mlarroque/TP-ELECTRO1/informe/imagenes/el_diego_foto_real.png

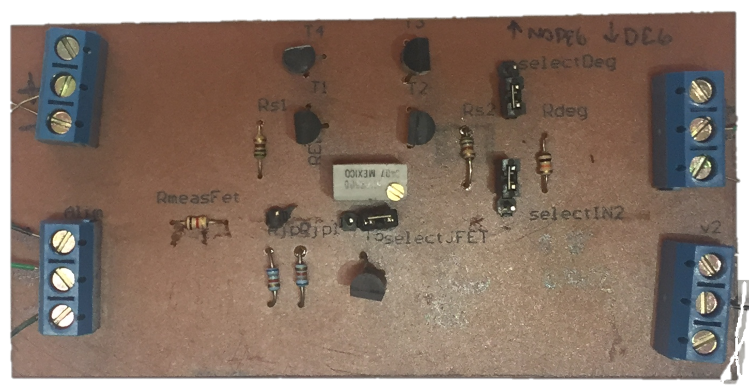
informe/imagenes/el_diego_foto_real.png
