mlarroque/TP-ELECTRO1/informe/imagenes/MonecarloDeCorrienteEnJFET.JPG

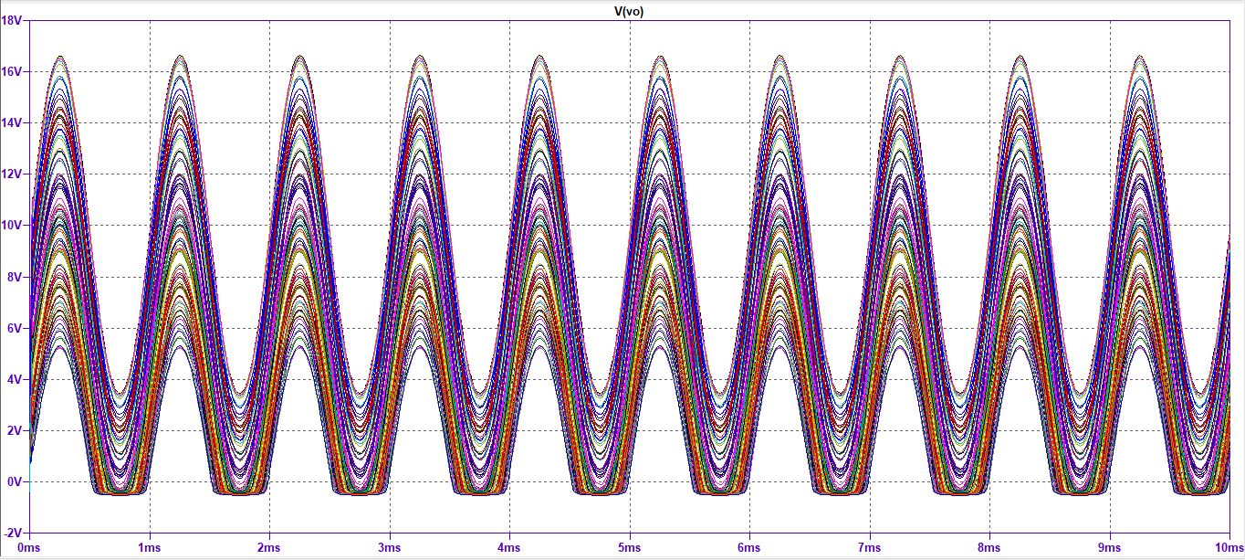
informe/imagenes/MonecarloDeCorrienteEnJFET.JPG
