mlarroque/TP-ELECTRO1/informe/informe_electro1.pdf

## Instituto Tecnológico de Buenos Aires

22.59 Electronica 1

Trabajo Práctico de Laboratorio No 2

# Amplicador Diferencial

Grupo 5:

Matías Larroque
Leg. 56597

Ariel Martorell
Leg. 56209

Manuel Mollón
Leg. 58023

Ezequiel Vijande
Leg. 58057

Profesor:

Fernando Alcocer
Pablo Gardella
Eduardo Oreglia

Entregado: 14 de Noviembre de 2018

## Índice

1. Amplicador Diferencial | 2

## 1. Amplicador Diferencial

1.1. Introducción

En este artículo se procederá a desarrollar el proceso de diseño e implementación de un amplicador con componentes (transistores y resistencias) discretos. El proceso de diseño se debe realizar a partir de los componentes que se adquieran dentro del marco de una simulación con recursos escasos, y en cuanto a al implementación, se realizará un prototipo que se pondrá a prueba mediante mediciones pertinentes para comprobar el funcionamiento del mismo.

1.2. Componentes Adquiridos

Los componentes adquiridos mediante la simulación de subasta son los siguientes: Par diferencial (con transistores NPN, BC547)
Transistor J-FET (de canal N, MPF102)
Transistor bipolar (NPN, BC557)
Fuente Espejo (con transistores PNP, BC547) Resistencia de 10KΩ
Resistencia de 6,8KΩ (dos unidades)
Placa de 5cm X 10 cm.
1.3. Elección del Circuito
1.3.1. Primera Aproximación - Circuito con Par Diferencial

Para la elección del circuito, se partirá de la siguiente conguración con un par diferencial:

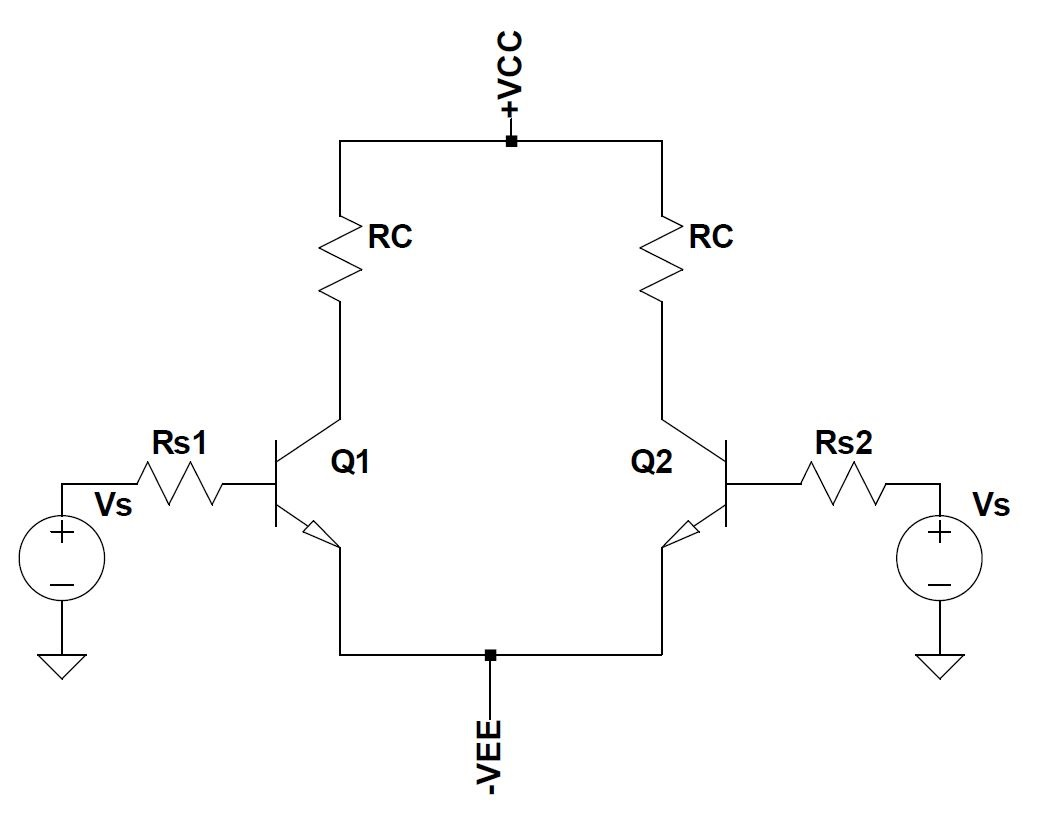
[picture p3: figure]

Figura 1: Circuito con Par Diferencial

Al resolver la polarización de este circuito, se podría plantear lo siguiente: IcQ1 ≈ IcQ2 ≈

VEE−VBEon
Rs1
HF E +2.REE

= IcQ
VCE = VCC + VEE − 2.IcQ.REE
Siendo HF E la ganancia de corriente (estática) de los transistores utilizados para el par diferencial (considerada igual para cada transistor) y VBEon ≈ 0,7V (caida de tensión por la juntura base emisor).
Luego, al plantear el circuito incremental se obtiene lo siguiente:

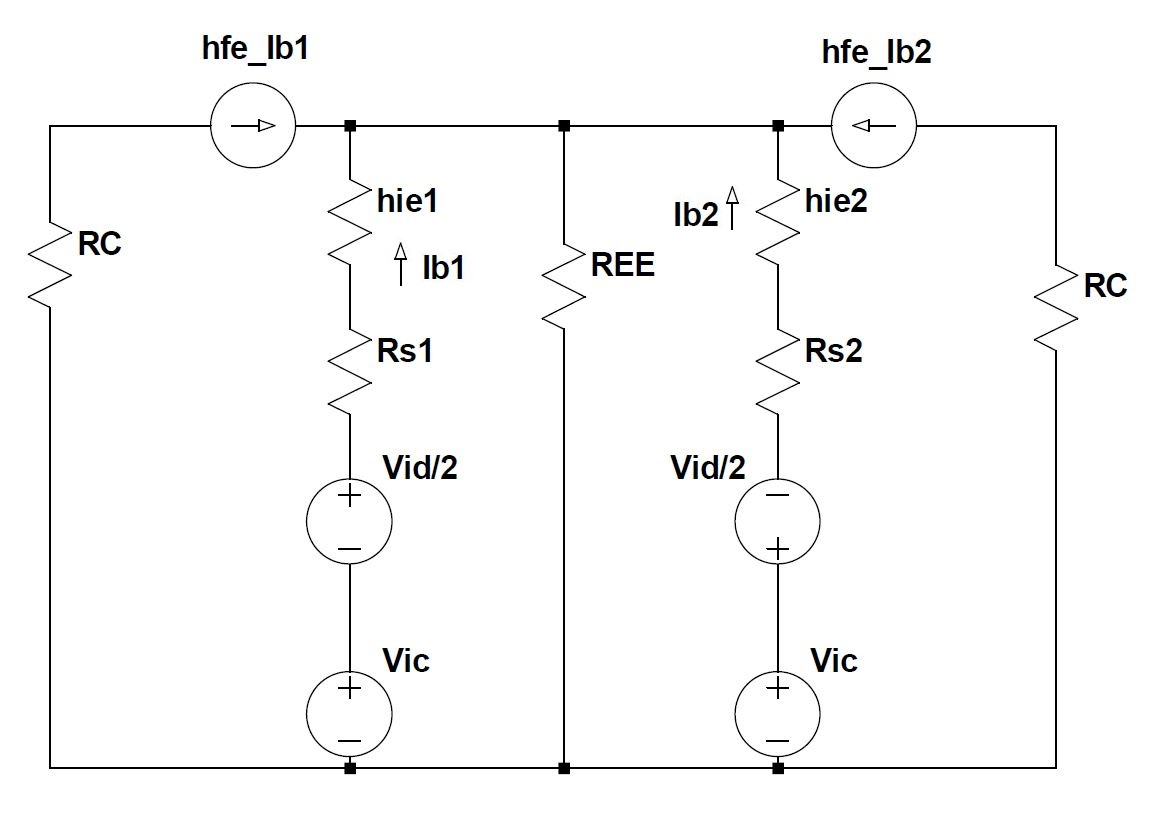
[picture p4: figure]

Figura 2: Circuito Incremental con Par Diferencial

Notesé que en la imagen de la derecha se representan las fuentes de señal mediante su modo común ”V ic” y su modo diferencial ”V id”. Esta forma de plantear la señal de entrada permite plantear el problema utilizando el principio de superposición. Por ende, para la resolución del circuito se procede a resolver el modo común (pasivando el modo diferencial) y luego el modo diferencial (pasivando las dos fuentes de modo común). En este proceso, debido a la simetría del circuito, se puede aplicar el teorema de bartlett para obtener los siguientes hemicircuitos, tanto para el caso de modo común (imagen de la izquieda) como para el de modo diferencial (imagen de la derecha):

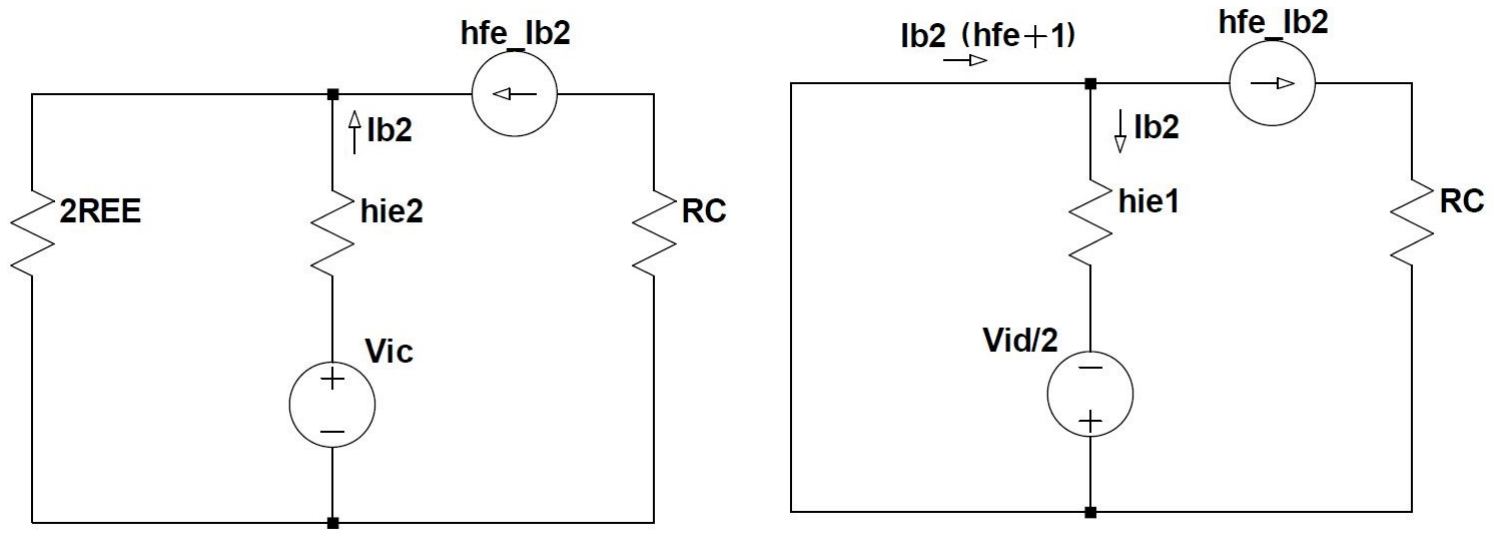
[picture p5: figure]

Figura 3: Hemicircuitos - Modo Común y Modo Diferencial

Es importante aclarar que para poder plantear los hemicircuitos se debe cumplir que la corriente del emisor en los dos transistores sean iguales.
Dicho esto, al plantear la transferecia se obtiene lo siguiente:

∆vdif erencial ,

vod
vid

≈

gm.Rc
2

; gm =

IcQ
VT

; VT ≈ 26mV

∆vcomun´ ,

voc
vic

≈ −

Rc
2.REE
CMRR∆ ,

∆vdiferencial

∆vcomun´

≈ −gm.REE
Es deseable que el parámetro CMRR (proporción de rechazo del modo común) sea lo mayor posible para que el circuito tome sentido en cuanto a su función de amplicador diferencial. Por ejemplo, para la transimisión de una señal balanceda (para las cuales el modo común es cero, al menos al inicio de su transimisión) no es deseable amplicar el modo común ya que sería equivalente a amplicar el ruido que se induce en la misma al ser transimitida, mientras que sí es deseable amplicar el modo diferencial que corresponde con la señal en si misma. Por ende, un CMRR mayor implica una mayor delidad de la señal resultante del amplicador, con respecto a la señal de entrada. Dicho esto, en el circuito propuesto se podría pensar que el CMRR se vería incrementado al aumentar el valor de la resistencia REE, sin embargo, esto a su vez produciría la disminución de gm ya que IcQes inversamente proporcional a REE, por lo cual no se obtiene un aumento de CMRR. Para provocar el aumento de CMRR tendría que encontrarse la manera de lograr un valor de REE elevado sin que disminuya IcQ. En la siguiente sección se planteará una modicación al circuito mediante un enfoque que permita solucionar este problema.
1.3.2. Segunda Aproximación - Polarización mediante Fuente de corriente

Ante la limitación de CMRR que presenta el circuito presentado anteriormente, se procede a analizar una posible mejora del mismo mediante la introducción de un transistor J-FET de la siguiente manera:

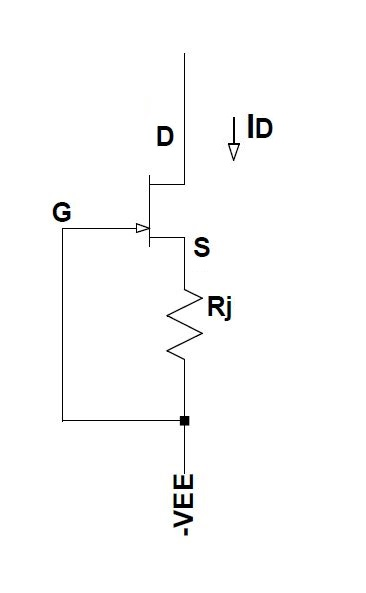
[picture p6: figure]

Figura 4: Circuito con J-FET

Dada la fórmula Schockley para la corriente de Drain del J-FET se puede notar que si el terminal de Gate y Source del transistor J-FET se encuentran al mismo potencial (VGS = 0), el transistor se convierte en una fuente de corriente ya que ID toma el valor de IDSS.
ID = IDSS.(1 −

VGS
VP

)

2
Sin embargo, para controlar aún más la corriente de Drain del transistor se puede incorporar la resistencia ”Rj” y obtener la siguiente expresión:
VGS = −ID.Rj ⇒ I

2
D + ID.(

2.VP
Rj −

V

2
p
Rj².IDSS

) + V

2
P

Rj² = 0
Según la hoja de datos del J-FET MPF 102 , VP ≈ 88 y además la corriente IDSS del transistor utilizado es de 1mA. En cuanto a la elección del valor de la resistencia ”Rj” debe tenerse en cuenta que la corriente IcQsea tal que el transistor opere en su zona segura de trabajo como amplicador (”ZOA”, del inglés safety operation zone). Con una resistencia Rj de 3,4KΩ se obtiene una ID de 780uA, lo cual asegura el correcto funcionamiento de los transistores que componen el circuito.
Entonces, cada transistor que conforma al par diferencial se proveerá de una corriente IcQ =

ID
2 ≈ 340uA
En cuanto al circuito incremental, se puede realizar el mismo análisis que ya se visto en el circuito con la resistencia REE, pero en lugar de esta resistencia habría que involucrar la resistencia RDS del transistor J-FET, por ende se obtiene lo siguiente:

∆vdif erencial ,

vod
vid

≈

gm.Rc
2

; gm =

IcQ
VT

; VT ≈ 26mV

∆vcomun´ ,

voc
vic

≈ −

Rc
2.RDS
CMRR∆ ,

∆vdiferencial

∆vcomun´

≈ −gm.RDS
Esto resulta en CMRR elevado debido al alto valor de RDS pero sin la necesidad de disminuir gm.
Con esta implementación se logra aumentar el CMRR, sin embargo aún no se obtiene una amplicación elevada de la señal de modo diferencial. Esta se podría mejorar aumentamdo la resistencia ”Rc”, pero así también se aumentaría la potencia disipada del circuito. A continuación se propondrá una nueva mejora al diseño que permite optimizar aún más la amplicación del modo diferencial, evitando la limitación por potencia.

Antes de nalizar este análisis, vale aclarar que si se agrega una resistencia ”Rj” entre Gate y Source del J-Fet para regular la corriente de polarización la resistencia RDSno representa a la intrínseca del transistor si no que

RDS = RDSintrinseca(1 + gm.Rj ).

1.3.3. Tercera Aproximación - Carga Activa

Para poder aumentar la ganancia del modo diferencial se propone el siguiente circuito:

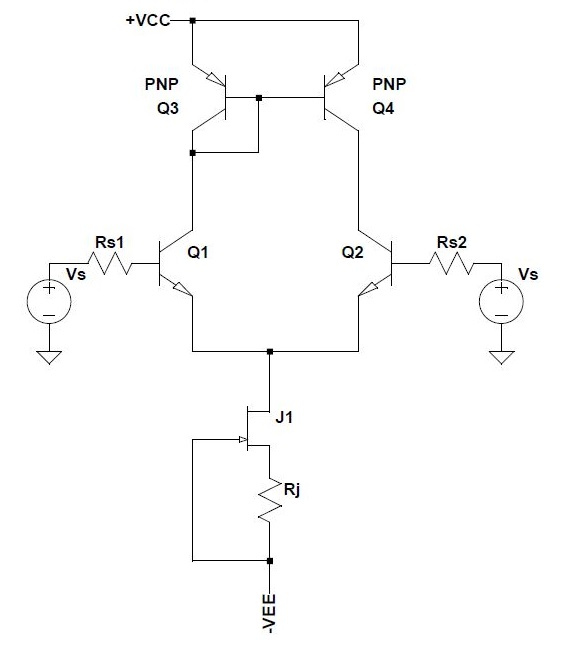
[picture p7: figure]

Figura 5: Circuito con Carga Activa - Fuente Espejo

Se puede observar de la gura que se reemplazaron las resistencias ”Rc” por una carga activa lograda mediante una fuente espejo con transistores PNP.
En cuanto a la polarización, esta no cambia con la incorporación de la fuente espejo. Solo se debe tener en cuenta que la fuente espejo sea capaz de copiar la corriente de colector de los transistores NPN del par diferencial.
El modelo incremental de este nuevo circuito es el siguiente:

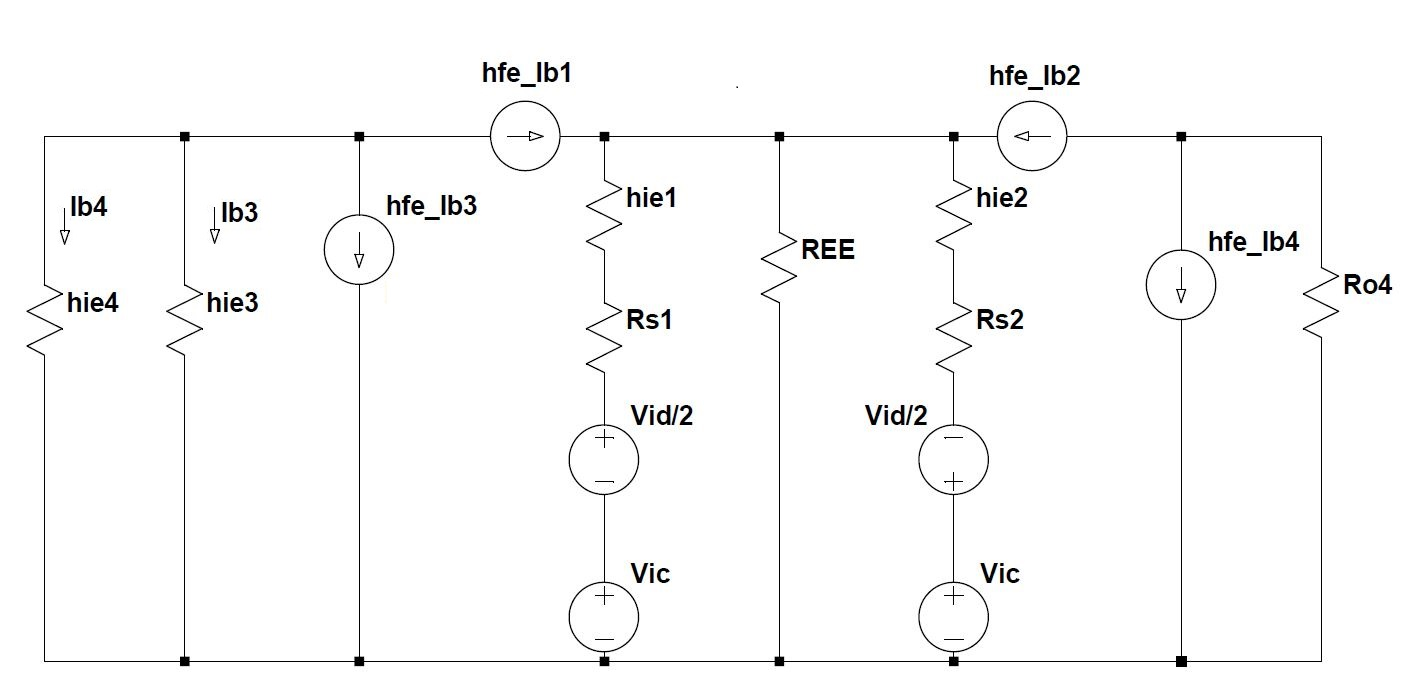
[picture p8: figure]

Figura 6: Circuito Incremental - Par Diferencial con Carga Activa

Luego, para analizar la ganancia en modo diferencial se debe proceder a pasivar el modo diferencial. De esta manera, al existir un incremento de modo diferencial en las tensiones de entrada se producirá un cambio en las corrientes del circuito de la siguiente manera:
IB1 = IB2 (por simetría del par diferencial)
IB3 = IB4 (coonsiderando hie3 = hie4)
IB3.(2 + hfe) ≈ IB1hfe ⇒ IB3 ≈ IB1.

hf e
2+hf e ≈ IB1

⇒Todas las corrientes de base se pueden considerar iguales⇒la tensión sobre la resistencia REE es cero. Luego, el nodo del emisor del transistor 1 se puede considerar como tierra virtual y se puede plantear el siguiente hemicircuito:

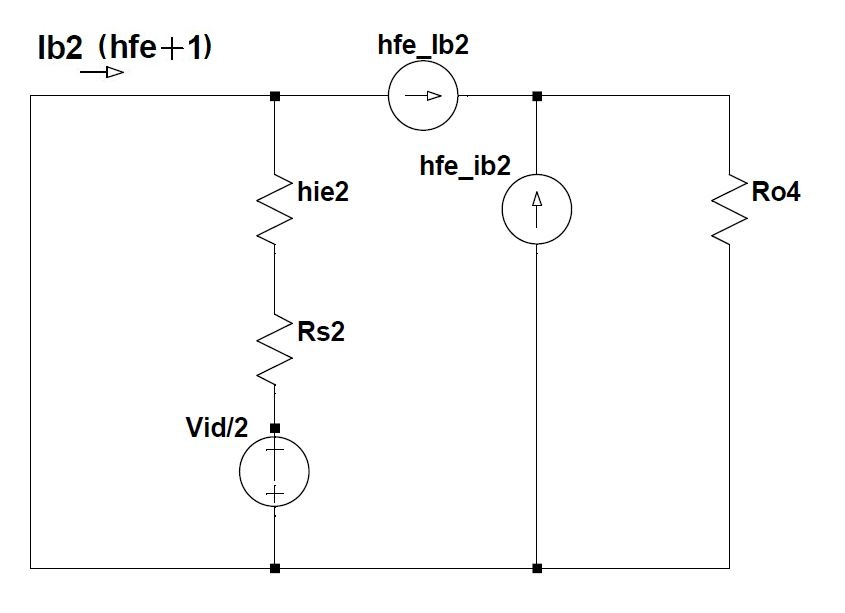
[picture p9: figure]

Figura 7: Hemicircuito Diferencial

Luego, se llega a que ∆vdif erencial = 1/2.

2.Ro4.hf e

hie2+Rs
Esto tiene sentido ya que la fuente espejo de corriente copia la corriente incremental del colector 1 y obliga a que esta corriente circule por la resistencia Ro4 junto con la corriente del colector 2.
En cuanto al circuito de modo común, teóricamente la ganancia es igual cero ya que en este caso la corriente de colector 2 tiene el mismo sentido que la corriente que copia la fuente espejo. Además la corriente que copia la fuente es igual a la corriente del colector 1, es decir que también es igual a la del colector 2. Por ende, la corriente que circula por la resistencia Ro4 es nula.
En realidad, este análisis no tiene en cuenta que la corriente copiada por la fuente espejo no es exactamente la corriente de referencia. Un aproximación más cercana a la realidad es plantear que la fuente copiada ”Io” es aquella obtenida mediante la expresión Io =

Iref
1+ 2
hfe

. De esta manera, la corriente ”I” que circula por la resistencia Ro4 en el

análisis de modo común es I = Iref−

Iref
1+ 2
hfe

= Iref .(

2
2+hf e ). Por lo tanto, ∆vcomun´ ≈ (Iref .(

2
2+hf e ).Ro4/Iref .RDS) ≈

2Ro4
(2+hf ePNP ).RDS
Dicho esto, la expresión de la proporción de rechazo al modo común es la siguiente: CMRR ≈

Ro4.hf eNPN

hie2+Rs

(2+hf ePNP ).RDS
2Ro4

=

2.hf ePNP .RDS+hf eNPN .hf ePNP .RDS 2.(hie2+Rs)

1.3.4. Cuarta Aproximación - Alternativa para Evitar Saturación

El circuito anteriormente analizado se puede caracterizar por su ganancia de tensión en modo diferencial elevada, sin embargo, esto tiene un límite debido a las fuentes de alimentación que polarizan los transistores. Más aún, al trabajar con tensiones de entrada elevadas, una ganancia como la analizada en el amplicador diferencial en cuestión, es contraproducente ya que provoca la saturación de la señal de salida y por ende se pierde gran parte de la información de la misma.
Este problema se puede evitar al agregar una resistencia ”RL” como carga. Esta carga provoca que disminuya la ganancia, y esto se puede ver sin modicar el análisis ya realizado para el modelo incremental. De hecho, en las expresiones de ganancia se debe reemplazar la resistencia Ro4 por el equivalente del paralelo entre Ro4 y RL.
1.4. Materialización

A la hora de realizar el prototipo del circuito se utilizaron las dos resistencias de 6,8KΩ asociadas en paralelo para formar la resistencia Rj de 3,4KΩy poder lograr la corriente ID de 780uA. Esta corriente fue comprobada experimentalmente en un prototipo aparte, ya que la hoja de datos del J-Fet utilizado (MPF102) no otorga un valor de IDSS (en realidad otorga un rango entre 2mA y 20mA) y por ende no se podía asegurar el valor de ID hasta medirlo en el laboratorio.

Una vez asegurado el valor de la corriente ID, solo se debió corroborar con la hoja de datos que los transistores BC557 y BC547 logren polarizarse correctamente con una corriente de ID/2, es decir, 340uA.
Al vericar esta condición, se concluyó que los transistores se polarizan correctamente y además presentan las siguientes características (teniendo en cuenta la corriente de polarización):
| BC547 (NPN) | BC557 (PNP)
hfe | 180 | 120
hie | 9KΩ | 7,35KΩ
Ro | 85KΩ | 70KΩ

Cuadro 1: Características de los Transistores

Finalmente, se realizó el prototipo del circuito con los componentes obtenidos en el sistema de subastas comen-tado al principio del artículo, pero además se agregó un jumper para poder medir el circuito propuesto en la tercera aproximación o el de la cuarta aproximación según se lo requiera. En cuanto a la cuarta aproximación, la RL utilizada fue de 10KΩ.
A continuación se muestra una imagen del prototipo del circuito:


Figura 8: Imagen del Prototipo

1.5. Simulación en LTspice

Se utilizó la herramienta de LTspice para simular el circuito propuesto anteriormente en la tercer aproximación. Como primer paso se procedió excitar el circuito con una pequeña señal senoidal de 5mV de amplitud en modo diferencial y se obtuvo la siguiente respuesta:

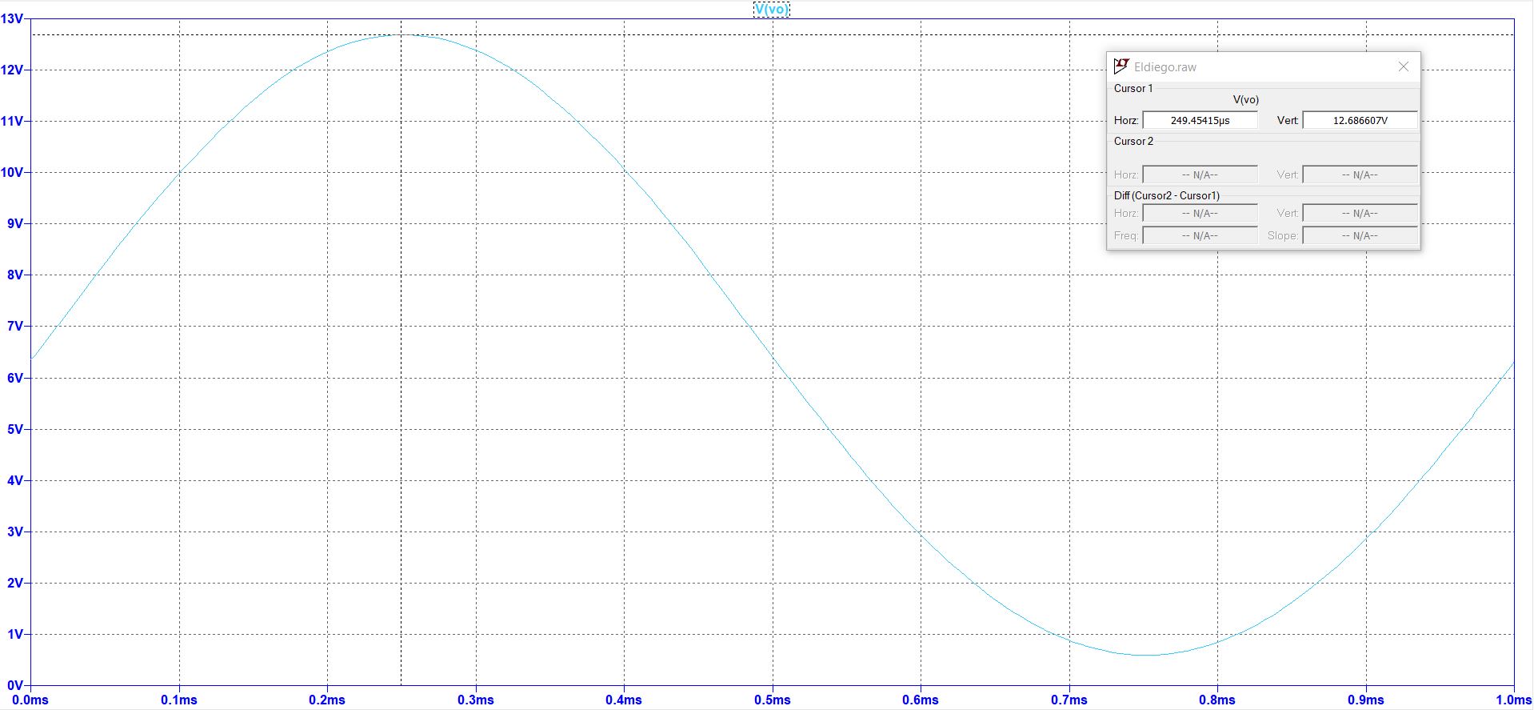
[picture p10: figure]

Figura 9: Tensión de Salida - Modo Diferencial

<
Luego se ingresaron 100mV en modo común y se obtuvo lo siguiente:

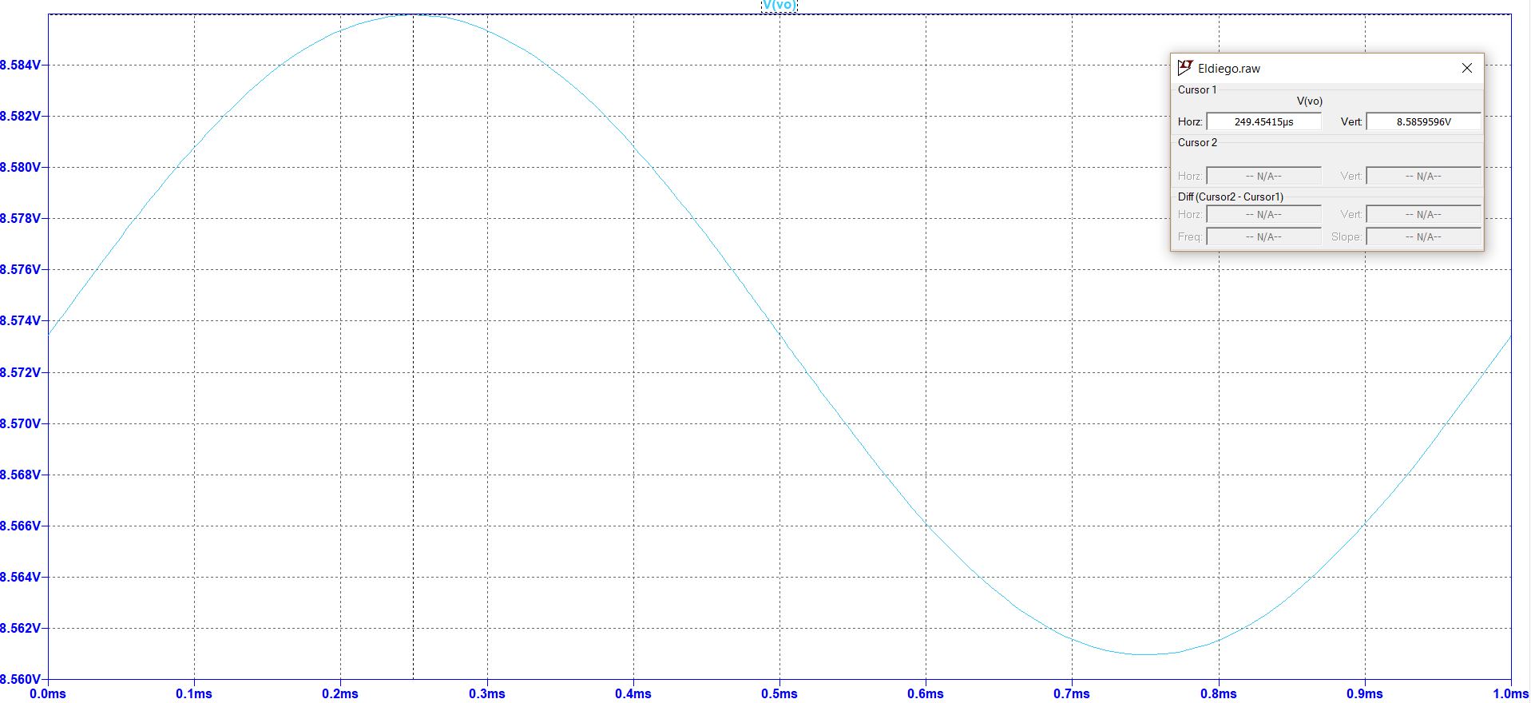
[picture p11: figure]

Figura 10: Tensión de Salida - Modo Común

De estas simulaciones se puede concluir que la ganancia en modo diferencial simulada es de aproximadamente 1200, mientras que la de modo común es de 0.002. Luego el CMRR es de 115.6dB
Por último, se realizó un análisis de Montecarlo de la ganancia en modo diferencial, al variar el valor de IDSS del transistor J-Fet utilizado para la polarización. A continuación se muestra el resultado:


Figura 11: Análisis de Montecarlo - Ganancia en Modo Diferencial ante Variaciones de ID

De esta simulación se puede notar que la variación de la corriente de polarización produce variaciones signica-tivas en la ganancia de tensión. Más aún, se puede notar que puede llegar a saturar la tensión de salida. En n, los resultados de esta simulación rearma la importancia del análisis de la polarización.
Para el circuito propuesto en la cuarta aproximación, también se simuló la tensión de salida al excitar con una tensión en modo diferencial de 100mV de amplitud (imagen de superior mostrada a continuación) y luego con 100mV de modo común (imagen inferior):

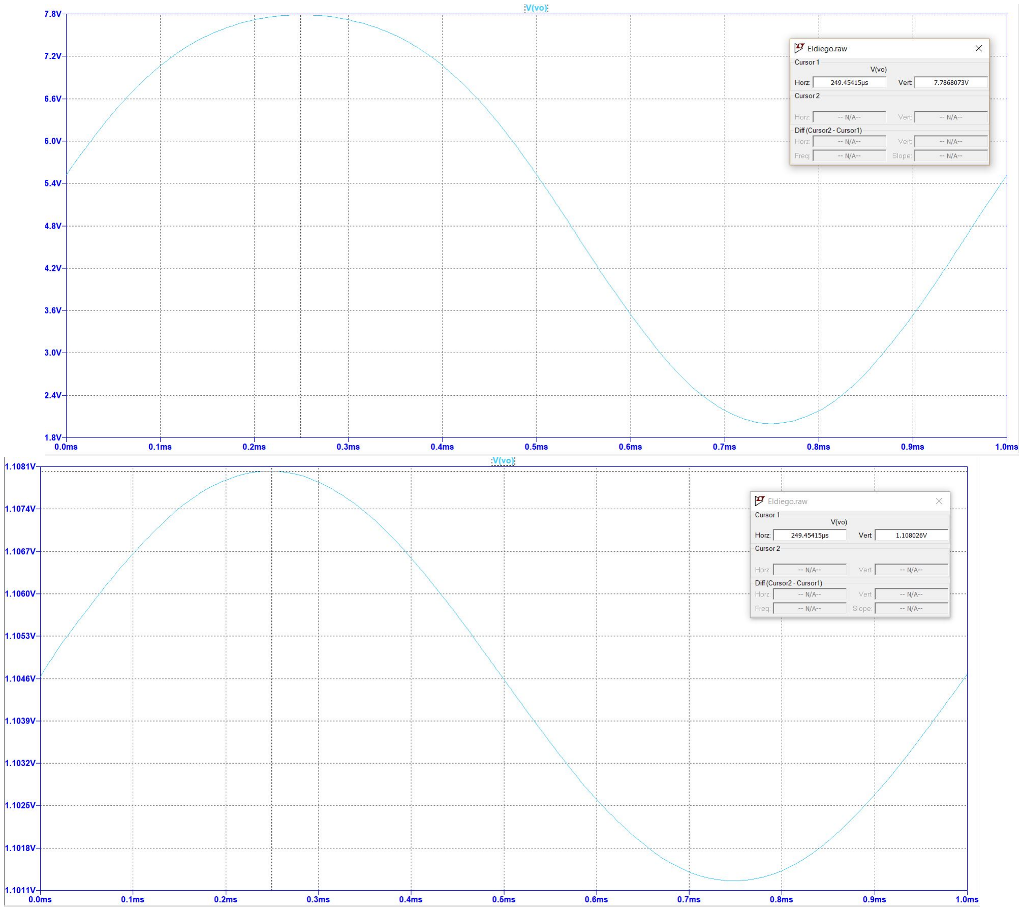
[picture p12: figure]

Figura 12: Simulaciones Modo Común y Diferencial - Cuarta Aproximación

Finalmente, la simulación indica una ganancia de modo común de 0.03, mientras que la de modo diferencial es 24, lo que signica un CMRR de 58.1.
Vale aclarar que la frecuencia de trabajo para las simulaciones fue de 1KHz.
1.6. Mediciones

Al momento de realizar de mediciones, primero se analizó el circuito propuesto en la tercer aproximación. Mediante el borne de entrada de V s1 se ingresó una excitación de senoidal 20mV de amplitud, mientras que el borne de entrada de V s2 se conecto a tierra, y se midió la señal de salida con el osciloscopio. A continuación se muestran las capturas de pantalla del mismo:

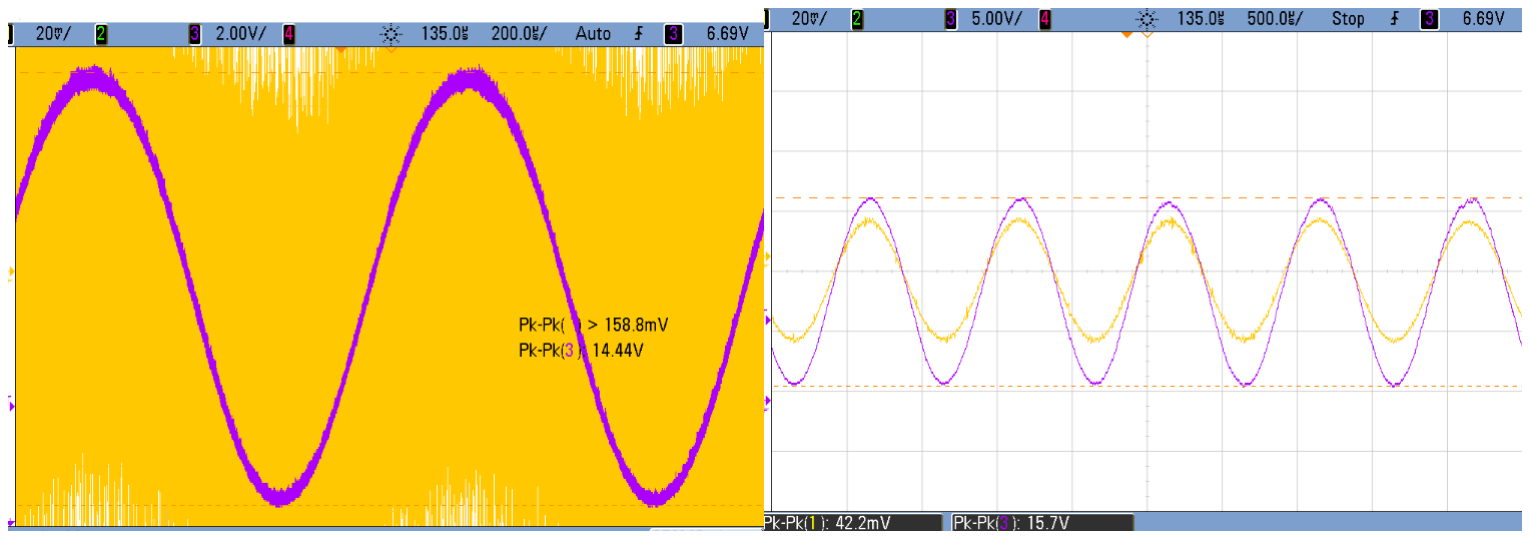
[picture p13: figure]

Figura 13: Medición con Osciloscopio - Circuito sin RL

Debesé tener en cuenta que la imagen de la izquierda fue tomada con ACQUIRE del osciloscopio en NORMAL mientras que para la de la derecha se utilizó el modo HIGH RESOLUTION.
Luego, a partir de estas imagenes se procede a calcular la ganancia de tensión como ∆v =

15,7V.(1000)
42,2V ≈ 372
Por otro lado, se procedió a realizar la misma medición para el circuito con RL y se obtuvo lo siguiente:

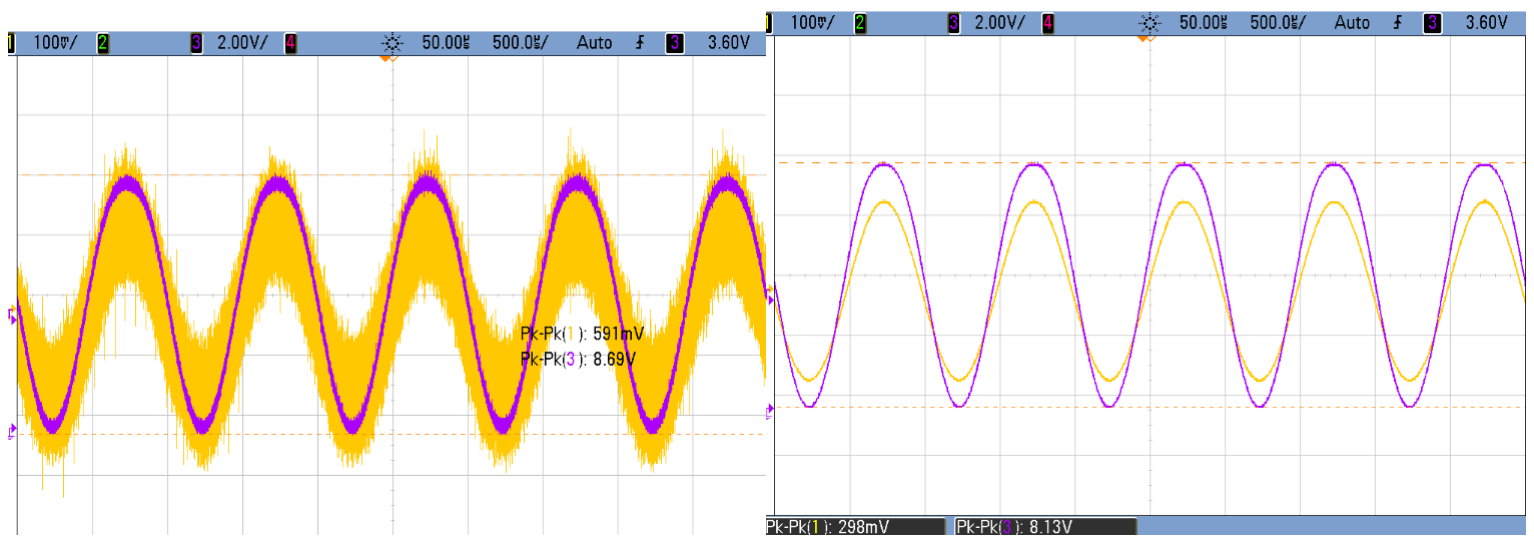
[picture p14: figure]

Figura 14: Medición - Circuito con RL

Luego, ∆v =

8,13V.(1000)
298V ≈ 27,3
Además, para el circuito con RL se utilizó el borne de V s2 para ingresar al circuito con una señal lo más aproximado posible a una diferencial pura, es decir con modo comíun nulo. A continuación se muestra el resultado obtenido:

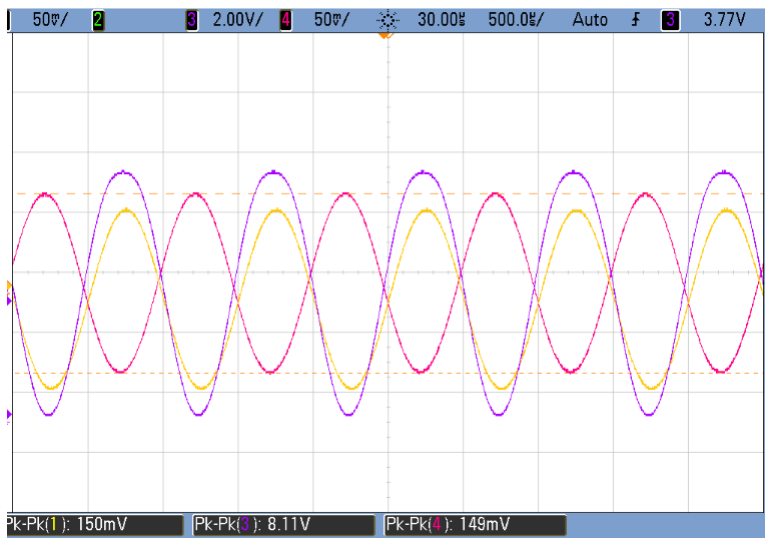
[picture p15: figure]

Figura 15: Medición - Excitación Diferencial

Luego, ∆vdif erencial =

8,11V.(1000)
300V ≈ 27,03. El motivo de esta medición es intentar mostrar que la ganancia en modo diferencial es signicativamente mayor a la ganancia del modo común del circuito.
Vale aclarar que este último análisis es tan solo una aproximación a partir de la medición tomada del osciloscopio. Finalmente, se procedieron a medir las impedancias de entrada y de salida del circuito con RL.
Para la impedancia de entrada se procedió a excitar el circuito con una señal de tensión, con una resistencia en serie al generador de dicha señal, y luego se midió la tensión a la entrada del circuito y se calculó la impedancia mediante la siguiente expresión:
Rin =

|Vin|.Rserie

|Vin−Vgenerador|
Con este razonamiento se obtuvo una impedancia de entrada de aproximadamente 270KΩ de magnitud. Aplicando el mismo método, se procedió a medir la impedancia de salida pero esta vez se ingresó la señal desde el borne de salida del circuito mientras que el borne de entrada se conectaron a tierra. Mediante este método se obtuvo una magnitud de 7,5KΩ.
Vale aclarar que la frecuencia de trabajo para las mediciones fue de 1KHz.
1.7. Análisis de Resultados

De las capturas de pantalla de osciloscopio mostradas en la sección anterior se puede notar que las mediciones se ven ampliamente afectadas por señales de ruido, ya que las señales que se ingresan al amplicador diferencial son comparables a los niveles de ruido que prevalecen en el laboratorio en el cual se tomaron dichas mediciones. Para poder tomar mediciones que describan mejor la realidad, fue de gran utilidad el modo de HIGH RESOLUTION del osciloscopio para promediar el ruido que se ingresó a la señal, sin embargo, es importante observar la realidad de lo que se mide mediante el modo NORMAL.
Los resultados obtenidos a partir de las mediciones tomadas al excitar el circuito solo mediante el borne de entradaV s1 son solo de ganancia y como era de esperar, la ganancia es mayor para el circuito sin RL con respecto al circuito que sí posee la resistencia de carga. Sin embargo, para extraer conclusiones particularmente para la ganancia en modo diferencial y en modo común y así poder obtener el CMRR de cada circuito se debe realizar un análisis más profundo que solo observar las amplitudes medidas por el osciloscopio.
Sin embargo, al observar la imagen en modo NORMAL del osciloscopio se puede notar que ambos circuitos poseen CMRR apreciable ya que la señal de entrada se visualiza con un ruido signicativamente mayor a la señal de salida, a pesar de que ambos puntos del circuito (tanto la entrada como la salida) fueron expuestos a las mismas señales de ruido.
1.8. Conclusión

Como conclusión del trabajo realizado, se puede armar que para diseñar un circuitos con transistores discretos se debe tener en cuenta la compatibilidad entre ellos, como por ejemplo sus puntos de polarización, hfe, hie y Ro, ya que en el análisis teórico generalmente se suelen desestimar estos posibles mismatch y eso provoca que se generen diferencias con los resultados de las mediciones experimentales. Además, se debe prestar especial atención sobre los niveles de ruido que pueden afectar mediciones que pretendan poner en evidencia resultados del modelo de pequeña señal del transistor.
Dicho esto, la experiencia mostró que ambos circuitos realizados son competentes debido a su ganancia de tensión en modo diferencial y por su relativamente alto rechazo al modo común, sobre todo el circuito sin RL. En cuanto al circuito con RL, este además ofrece un rango lineal que acepta señales de hasta 150mV de amplitud, lo cual es aceptable para circuitos que se resuelven mediante el análisis de pequeña señal.
Finalemente, se han logrado medir impedancias de entrada y de salida medias que pueden ser fácilmente llevadas a los extremos (por ejemplo, impedancia de entrada superior e impedancia de salida inferior) mediante otras etapas de baja complejidad.
