mlarroque/TP-ELECTRO1/informe/imagenes/originals/4primeros.pdf

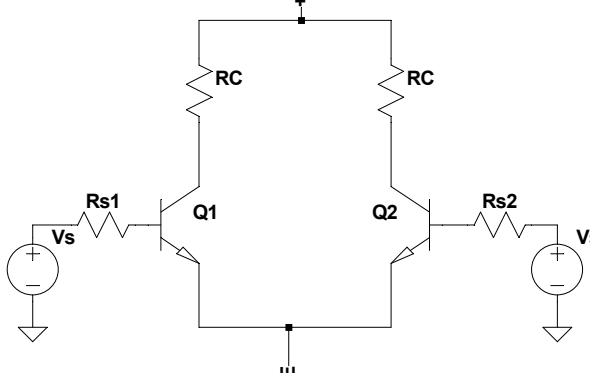
[picture p16: figure]

2REE

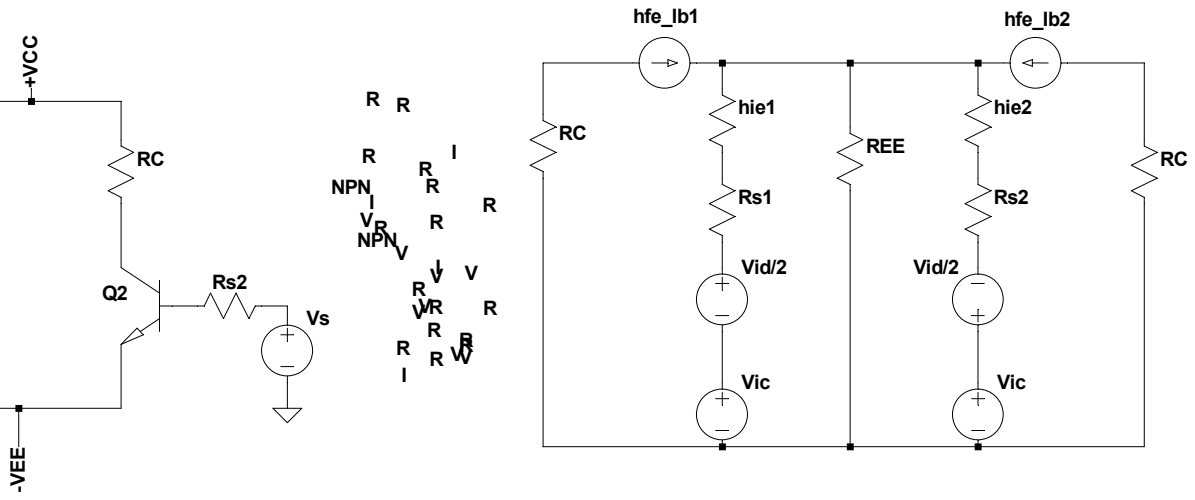
[picture p17: figure]
NPN; hfe_Ib1; hfe_Ib2; hie1; REE; hie2; Vid/2; Vic; V -VEE ⁺VCC

hie2

RC

hfe_Ib2

Vic

hie1

RC

hfe_Ib2

Vid/2

## --- C:\Users\marth\Documents\GitHub\TP-ELECTRO1\Draft1.asc ---
