mlarroque/TP-ELECTRO1/informe/imagenes/originals/segunda tanda.pdf

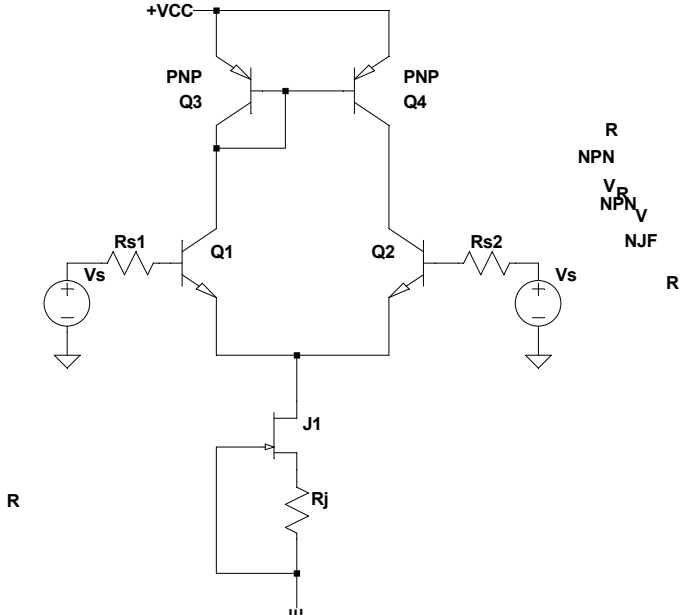
[picture p18: figure]
NPN; PNP; NJF
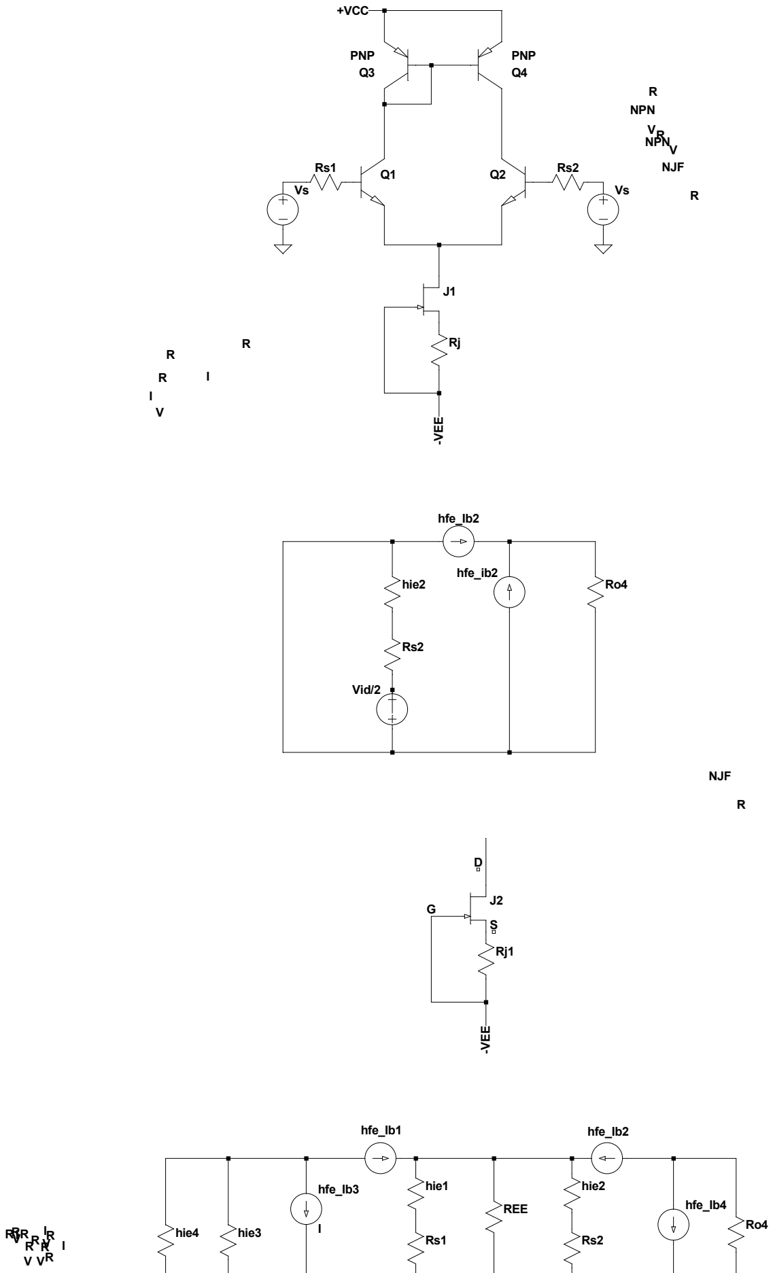
[picture p19: figure]
hfe_Ib1; hfe_Ib2; hie1; REE; hie2; NJF; Vid/2; hfe_ib2; hie4; hie3; hfe_Ib4; hfe_Ib3; I -VEE; +VCC; -VEE
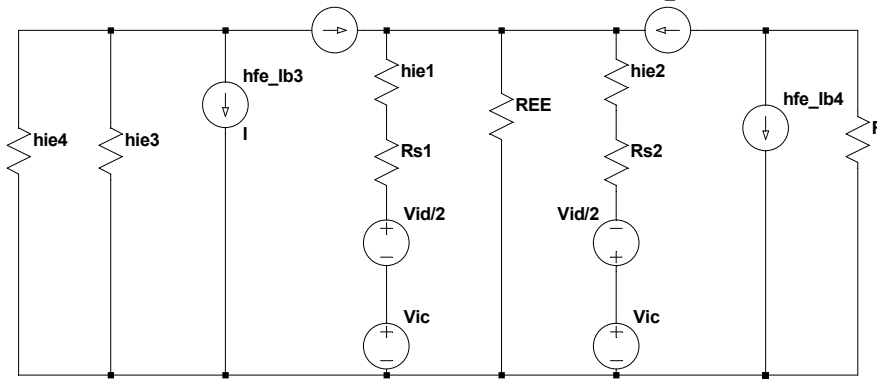
[picture p20: figure]
Vid/2; Vic

## --- C:\Users\marth\Documents\GitHub\TP-ELECTRO1\dibujos_segunda_tanda.asc ---
