mlarroque/TP-ELECTRO1/altium/overlayAltium.pdf

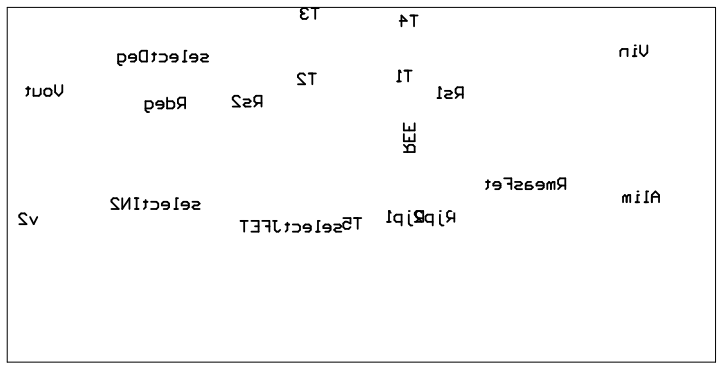
[picture p21: figure]
