mlarroque/TP-ELECTRO1/informe/imagenes/3_a.JPG

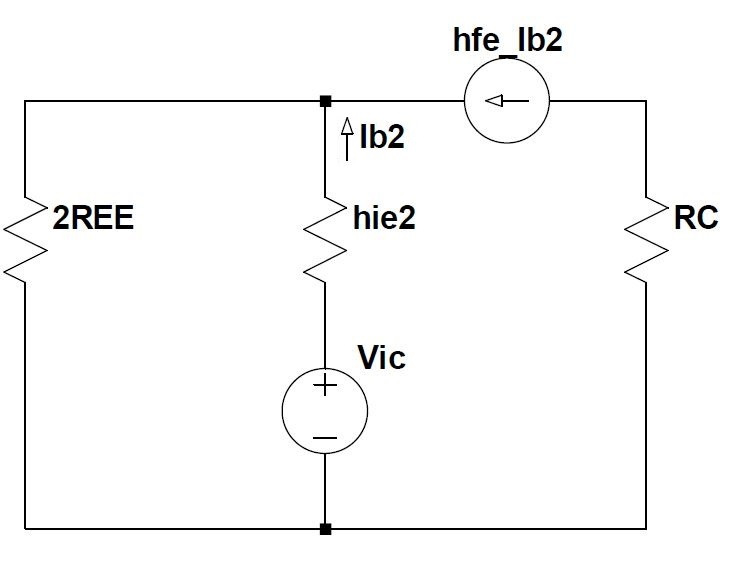
informe/imagenes/3_a.JPG
