mlarroque/TP-ELECTRO1/informe/imagenes/3_b.JPG

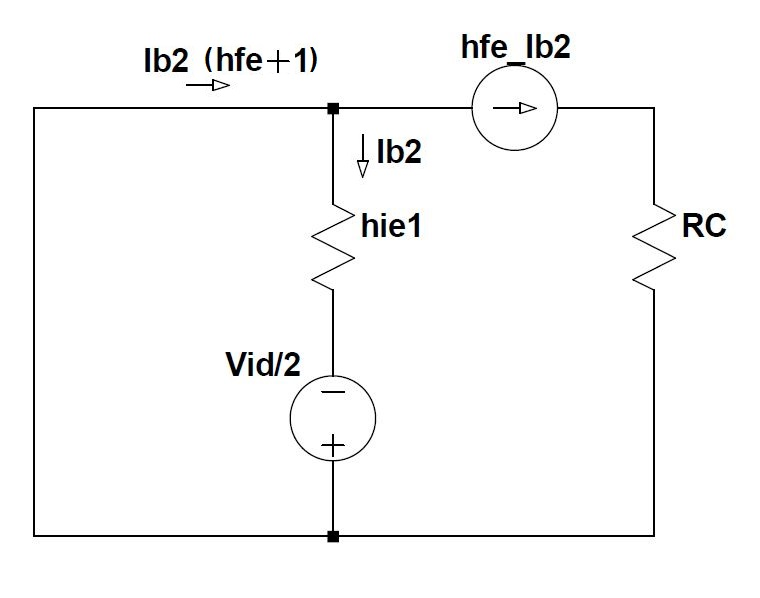
informe/imagenes/3_b.JPG
