mlarroque/TP-ELECTRO1/informe/imagenes/mediciones/HRES_deg_gainV.PNG

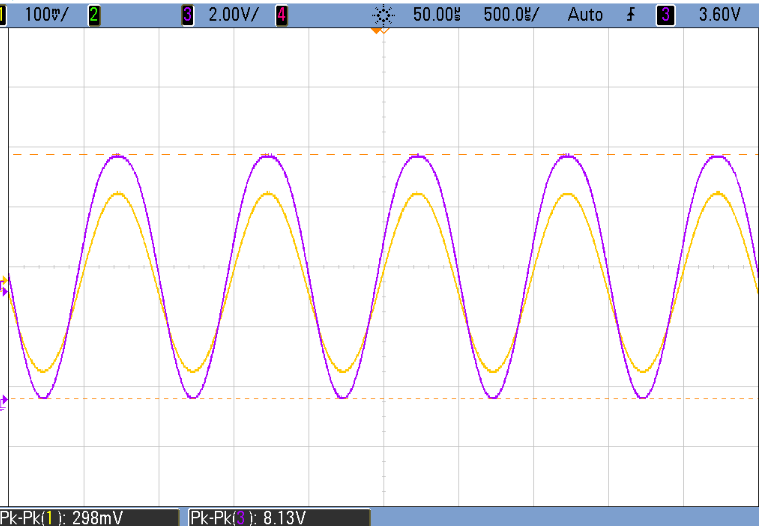
informe/imagenes/mediciones/HRES_deg_gainV.PNG
