mlarroque/TP-ELECTRO1/informe/imagenes/mediciones/HRES_gainV.PNG

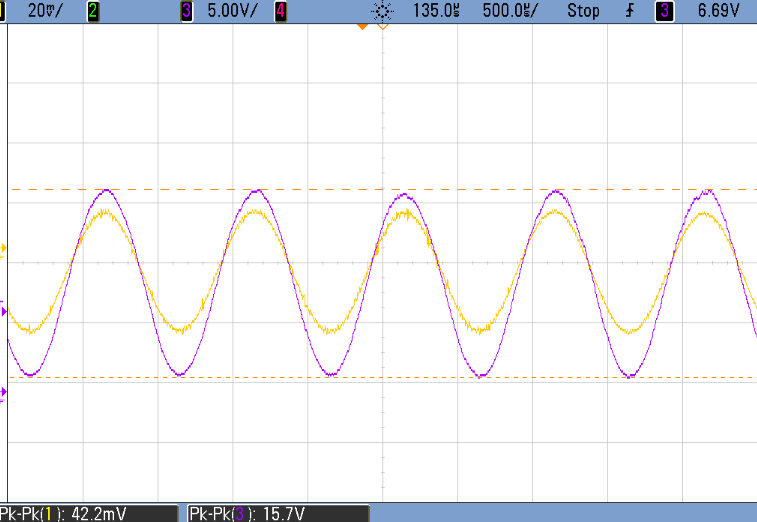
informe/imagenes/mediciones/HRES_gainV.PNG
