mlarroque/TP-ELECTRO1/informe/imagenes/mediciones/MDif_deg_gainV.PNG

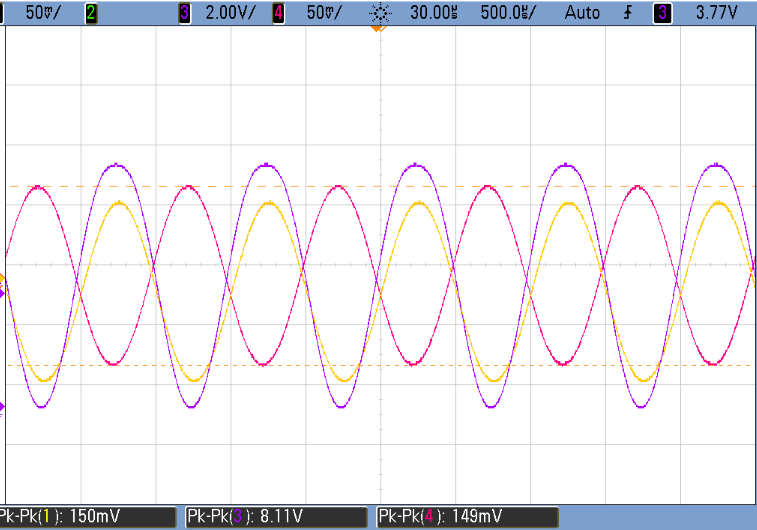
informe/imagenes/mediciones/MDif_deg_gainV.PNG
