mlarroque/TP-ELECTRO1/informe/imagenes/mediciones/normalMeas_deg_gainV.PNG

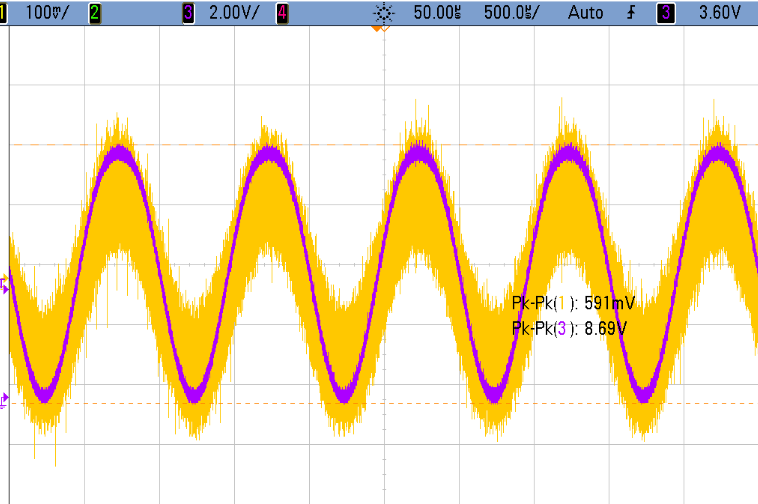
informe/imagenes/mediciones/normalMeas_deg_gainV.PNG
