mlarroque/TP-ELECTRO1/informe/imagenes/mediciones/normalMEAS_gainV.PNG

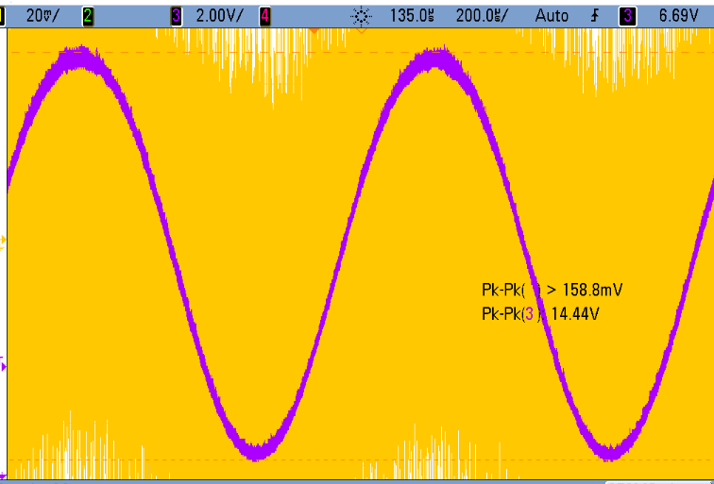
informe/imagenes/mediciones/normalMEAS_gainV.PNG
