mlarroque/TP-ELECTRO1/informe/imagenes/Tension_salida_modo_diferencial_carga_10k.JPG

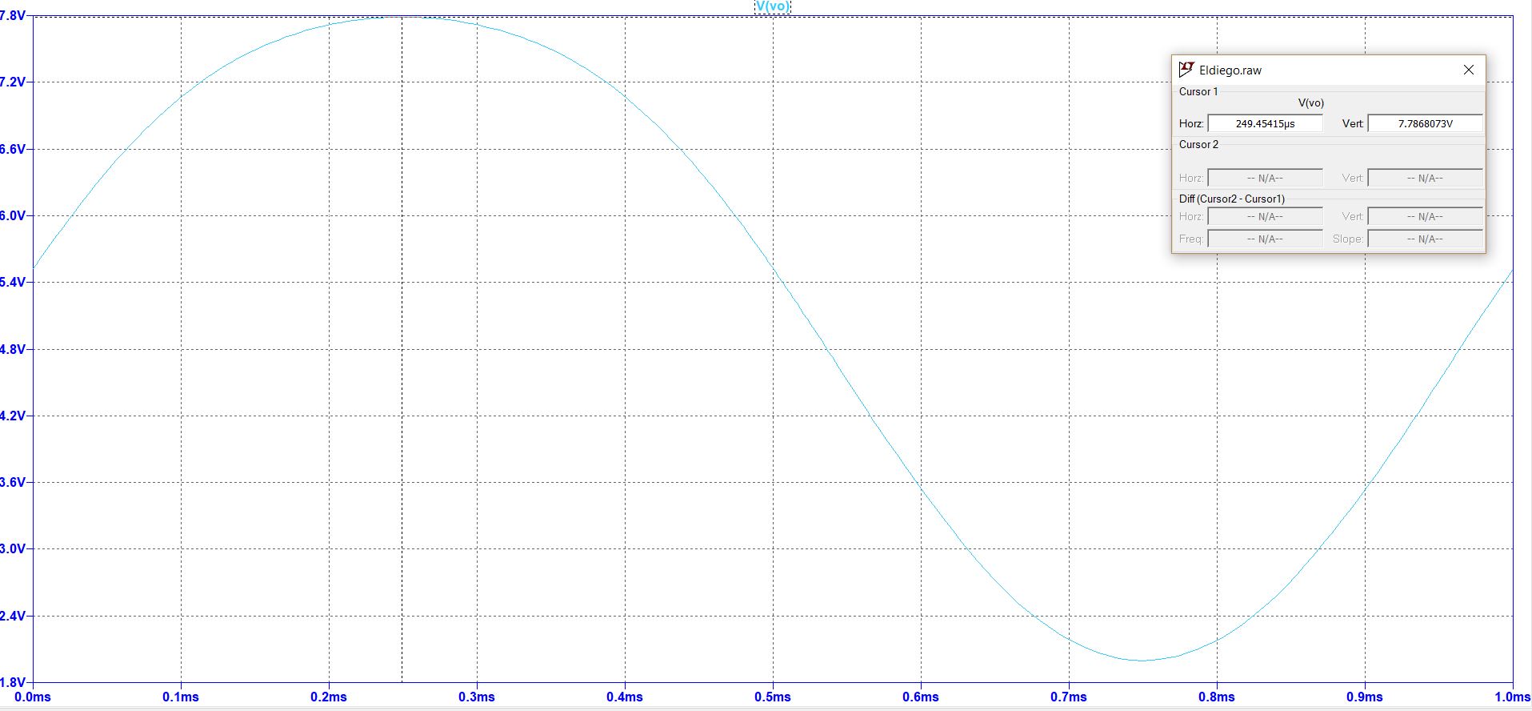
informe/imagenes/Tension_salida_modo_diferencial_carga_10k.JPG
