mlarroque/TP-ELECTRO1/informe/imagenes/VOenFuncionDeCorrienteDelJFET.JPG

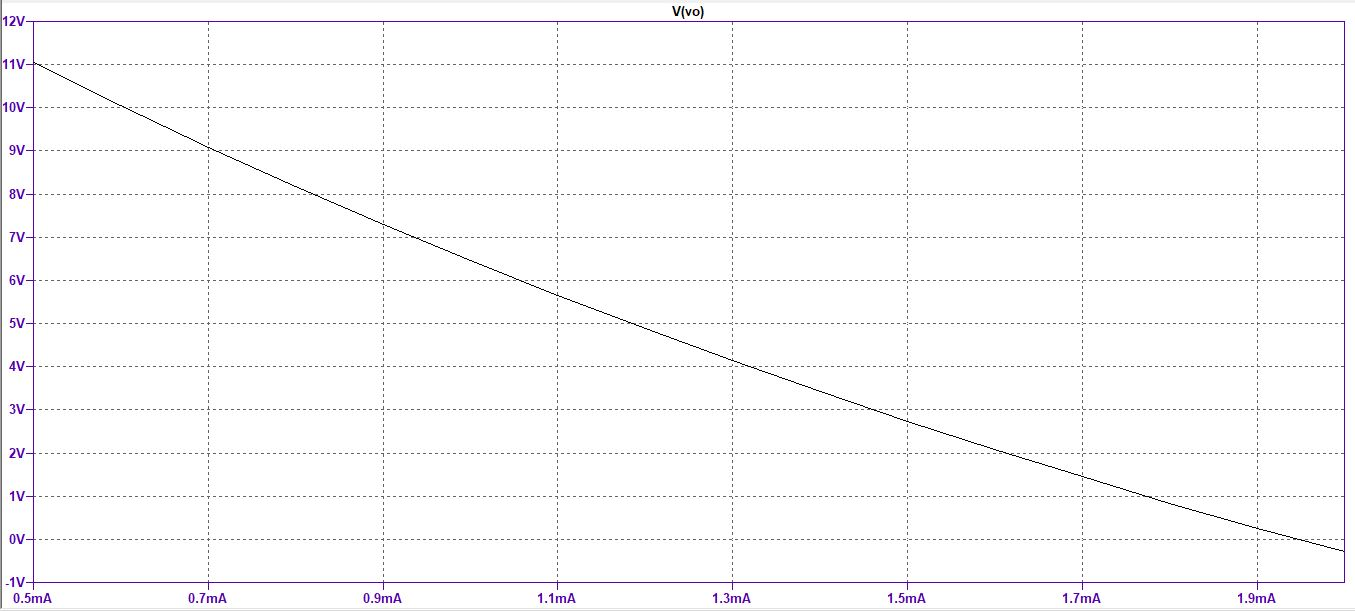
informe/imagenes/VOenFuncionDeCorrienteDelJFET.JPG
