mlarroque/TP-ELECTRO1/altium/bottomAltium.pdf

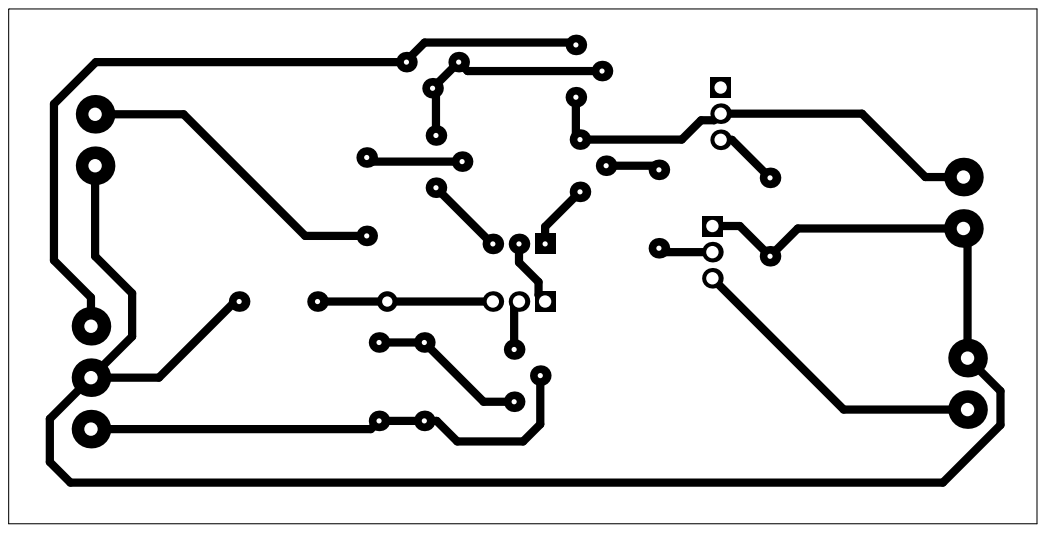
[picture p31: page 1]
