mlarroque/TP-ELECTRO1/informe/imagenes/originals/dibujos_primera_tanda.asc

2REE: res
hfe_Ib1: current
hfe_Ib2: current
hfe_Ib2: current
hfe_Ib2: current
hie1: res
hie1: res
hie2: res
hie2: res
Q1: npn
Q2: npn
RC: res
RC: res
RC: res
RC: res
RC: res
RC: res
REE: res
Rs1: res
Rs1: res
Rs2: res
Rs2: res
Vic: voltage
Vic: voltage
Vic: voltage
Vid/2: voltage
Vid/2: voltage
Vid/2: voltage
Vs: voltage
Vs: voltage
Named nets: 0, -VEE, +VCC
