mlarroque/TP-ELECTRO1/informe/imagenes/originals/dibujos_segunda_tanda.asc

hfe_Ib1: current
hfe_Ib2: current
hfe_Ib2: current
hfe_ib2: current
hfe_Ib3: current
hfe_Ib4: current
hie1: res
hie2: res
hie2: res
hie3: res
hie4: res
J1: njf
J2: njf
Q1: npn
Q2: npn
Q3: pnp
Q4: pnp
REE: res
Rj1: res
Rj: res
Ro4: res
Ro4: res
Rs1: res
Rs1: res
Rs2: res
Rs2: res
Rs2: res
Vic: voltage
Vic: voltage
Vid/2: voltage
Vid/2: voltage
Vid/2: voltage
Vs: voltage
Vs: voltage
Named nets: 0, -VEE, +VCC, D, G, S
