mlarroque/TP-ELECTRO1/spice/Eldiego.asc

J1: njf; MPF102
Q1: npn; Qbc547b
Q2: npn; Qbc547b
Q3: pnp; Qbc557b
Q4: pnp; Qbc557b
R2: res; 560
R3: res; 35
R4: res; 1
R7: res; 1Meg
Rj: res; 3.4k
Rs1: res; 560
V1: voltage; SINE(0 15m 1k); AC 10m
V2: voltage; 18
V3: voltage; 18
V4: voltage; SINE(0 0m 1k)
Named nets: 0, +vcc, -vee, vo, a, b
.inc jFet.txt
.tran 1m
.inc BC557B SP2.SP2
.inc BC547B SP2.SP2
