mlarroque/TP-ELECTRO1/(list of files, drawings)

Other design files:
altium/electro1.PcbDoc
altium/electro1.SchDoc
