mlarroque/TP-ELECTRO1/(commit log)

2018-11-04 se avanza con el informe
2018-11-06 avance con la simulacion e incorporacion de algunas hojas de datos
2018-11-12 ya esta la placa
    [electro1.PcbDoc, electro1.SchDoc]
2018-11-14 Cambie el spice
2018-11-14 SImulacion de la corriente en el J-FET
2018-11-14 ahi va el diego
2018-11-14 avances con electro1
    [rtaFrecuenciaV1.xlsx]
2018-11-14 avances con el informe
    [rtaFrecuenciaV1.xlsx]
2018-11-14 version final del informe de electro1
2018-11-26 se sube el informe
